tmikic100/GardenWAM/GardenWAM.pptx

## GardenWAM

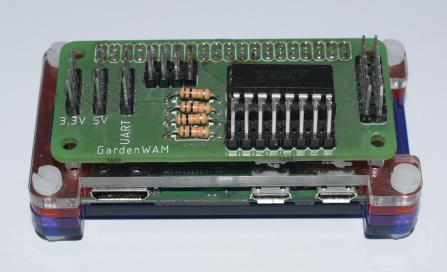
[picture p19: figure]

Izradio: Tomislav Mikić
Mentor:

## Slide 2

- Sadržaj prezentacije:
  - UVOD
  - HARDVER
  - SOFTVER
  - ZAKLJUČAK
      - TRAJANJE PREZENTACIJE 15’

## Slide 3

UVOD
- Automatizacija vrta
  - Mjerenje:
    1. Vlage tla i zraka
    2. Temperature tla i zraka
  - Automatizacija pomoću:
    1. Pumpa
    2. ventila
- Sučelje je web stranica

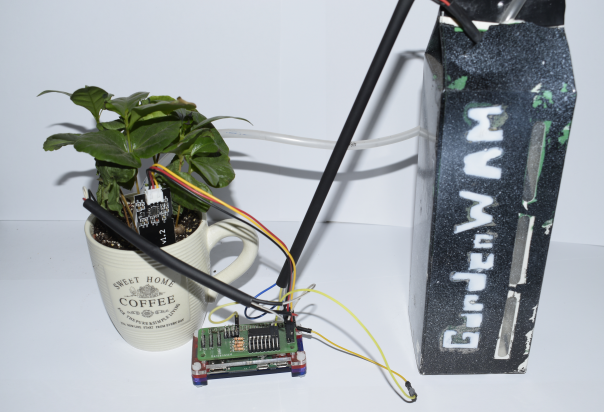
[picture p20: figure]

## Slide 4

HARDVER
- Poslužitelj
  - Hosta web stranicu
  - Baza je Raspberry pi 0w
- Shield
  - Služi za automatizaciju
  - Na njega idu razni:
    1. Senzori
    2. Aktuatori

LM335Z

## Slide 5

SOFTVER
- Baza podataka
  - Spremanje opcija i podataka
  - Koristio MarinaDB
- API
  - Komukacija razlicith slojeva
  - Koristio PHP
- Web stranica
  - Prikaz podataka
  - Napavljena od manjih modula
  - Koristio CSS, HTML i PHP
- Program za očitanje senzora i upravljanja aktuatorima
  - Koristio Python


## Slide 6

ZAKLJUČAK
PRIMJENJIVOST:
- Projekt može se koristi za automatizaciju:
  - Vrtova
  - Kućnih biljaka
PLANOVI ZA BUDUĆNOST:
- Bolja funkcionalnost shielda
- Softverske optimizacije
- Veća mogućnost modularnosti

## Slide 7

PITANJA?

Hvala na pažnji

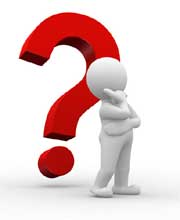
[picture p21: figure]
GAUS magneti | Česta pitanja
