tmikic100/GardenWAM/(list of files, drawings)

Other design files:
PCB/GardenWAM.fzz
